ColtonTshudy/battery-node/simulations/FET Driver rev2 bjt_test.asc

C2: cap; 0.05µ
C3: cap; 0, ic=0
D4: zener; TDZ16B
D7: schottky; RB168L100
M1: nmos; R6020PNJ
Q1: npn; 2SCR542F3
Q2: npn; 2SCR542F3
Q3: pnp; 2SAR340P
R1: res; 100
R2: res; 10k
R3: res; 600
R4: res; 10Meg
R5: res; 10m
R6: res; 10k
R9: res; 75
R10: res; 1
V1: voltage; 60
V2: voltage; PULSE(0 -450 5m 1n 1 1 1 1)
V3: voltage; PULSE(-50 -60 5.1m 1n 1n 1 1 1)
V4: voltage; 12
Named nets: src, gate, 0
.tran 0 10m 0
.model Tvs d Ron=10m Vfwd=450 Vrev=450 Epsilon=1 RevEpsilon=1
.model DMZ6012E VDMOS(Rg=100 Vto=-2.2 Rd=25 Rs=5 Rb=40 Kp=0.1 mtriode=1 Cgdmax=20p Cgdmin=2p Cgs=60p Cjo=50p Vds=600 Ron=60 Qg=1.5n)
