ColtonTshudy/battery-node/simulations/FET Driver rev2 dep_fet_test.asc

C1: cap; 0.1µ
C2: cap; 0.05µ
C3: cap; 0, ic=0
D1: schottky; RB168MM100
D2: zener; TDZ16B
D3: schottky; RB168L100
D4: schottky; RB168MM100
D5: zener; UMZ5_1N
D6: TVSdiode; Tvs
D7: schottky; RB168L100
M1: nmos; R6020PNJ
M2: nmos; R6020PNJ
M3: nmos; AOB66916L
M4: pmos; IRF9640
M5: nmos; R6020PNJ
R1: res; 10Meg
R2: res; 10k
R3: res; 300
R4: res; 10Meg
R5: res; 10m
R6: res; 100
R7: res; 56k
R8: res; 806
R9: res; 25
R10: res; 1
R11: res; 300
R12: res; 10Meg
R13: res; 10k
V1: voltage; 60
V2: voltage; PULSE(0 -450 5m 1m 1 1 1 1)
V3: voltage; PULSE(12 -60 5.1m 1n 1n 1 1 1)
Named nets: div, src, gate, 0, drain
.tran 0 10m 0
.model Tvs d Ron=10m Vfwd=450 Vrev=450 Epsilon=1 RevEpsilon=1
.model DMZ6012E VDMOS(Rg=100 Vto=-2.2 Rd=25 Rs=5 Rb=40 Kp=0.1 mtriode=1 Cgdmax=20p Cgdmin=2p Cgs=60p Cjo=50p Vds=600 Ron=60 Qg=1.5n)
