ColtonTshudy/battery-node/simulations/FET Driver rev4_breaking_setup.asc

C1: cap; .1µ
C2: cap; 0.05µ
D1: schottky; RB168MM100
D2: zener; TDZ16B
D3: schottky; RB168L100
D4: zener; TDZ16B
D5: zener; UMZ5_1N
D6: TVSdiode; Tvs
M1: nmos; AOB66916L
M2: pmos; SQ4937EY_Q2
M3: nmos; AOB66916L
R1: res; 10Meg
R2: res; 10k
R3: res; 1k
R4: res; 10Meg
R5: res; 10m
R6: res; 10
R7: res; 100k
R8: res; 1
R9: res; 75
V1: voltage; 60
V2: voltage; PULSE(0 -50 5m 1m 1 1 1 1)
V3: voltage; PULSE(12 -60 5.01m 1n 1n 1 1 1)
Named nets: div, src, gate, term, 0, bat
.tran 0 10m 0
.model Tvs d Ron=10m Vfwd=100 Vrev=100 Epsilon=1 RevEpsilon=1
