ColtonTshudy/battery-node/simulations/NMOS Gate Charge Test.asc

A1: and; ref=3.6 rout=.1m vhigh=10 td=30
C1: cap; 1n ic=0
D1: diode
M1: nmos; AON6560
R1: res; .1
V1: voltage; 10
Named nets: cccv_in, cccv_out, 0
.model d d ron=.1m roff=1meg vfwd=0.0 ilimit=1
.tran 0 1u 0
