ColtonTshudy/battery-node/simulations/cell balance.asc

Q1: npn; PBSS4350T
R1: res; 100
R2: res; 10
R3: res; 25
R4: res; 220
R5: res; 100
V1: voltage; 4
Named nets: 0
.tran 0 1 0
.MODEL PBSS4350T NPN(IS=5E-15 NF=1.002 ISE=2E-14 NE=1.60 BF=220 IKF=1.8 VAF=80 NR=1.0 ISC=1E-14 NC=1.20 BR=8 IKR=0.5 VAR=12 RB=18 RBM=1.5 IRB=0.01 RE=0.04 RC=0.08 CJE=10E-12 VJE=0.75 MJE=0.33 CJC=2.5E-12 VJC=0.65 MJC=0.35 XCJC=0.75 TF=1.0E-9 XTF=3.0 VTF=5.0 ITF=0.8 TR=50E-9 XTB=1.60 EG=1.11 XTI=3.0 FC=0.5)
