ColtonTshudy/battery-node/simulations/Draft1.asc

Q1: npn; QSX2
R1: res; 330
R2: res; 10
R3: res; 25
R4: res; 82
R5: res; 330
V1: voltage; 4
Named nets: 0
.tran 0 1 0
