ColtonTshudy/battery-node/simulations/Draft2.asc

C1: cap; 1n, ic=0
C2: cap; 1n, ic=0
D1: diode
R2: res; 10k
R3: res; 1
V1: voltage; 60
Named nets: 0
.tran 0 1 0
.model d d ron=0 roff=1meg vfwd=0.4 ilimit=100u
