ColtonTshudy/battery-node/simulations/Draft3.asc

C1: cap; 1µ, ic=0
D1: schottky; BAT46WJ
M1: nmos; SPA11N60C3
R1: res; 10k
R2: res; 1
R3: res; 50
R4: res; 1Meg
V1: voltage; -450
V2: voltage; 10
V3: voltage; 60
Named nets: 0, v+, v-
.tran 0 1 0
I(R1)*(v(v+)-v(v-))
