ColtonTshudy/battery-node/simulations/Draft4.asc

M1: nmos; DMZ6012E
R1: res; 1k
V1: voltage; DC
V2: voltage; 70
Named nets: 0
.model DMZ6012E VDMOS(Rg=100 Vto=-2.2 Rd=25 Rs=5 Rb=40 Kp=0.1 mtriode=1 Cgdmax=20p Cgdmin=2p Cgs=60p Cjo=50p Vds=600 Ron=60 Qg=1.5n)
.dc V1 70 0 1
