ColtonTshudy/battery-node/simulations/FET Driver rev2 broken.asc

C1: cap; 0.1µ
C2: cap; 0.05µ
C3: cap; 60n, ic=0
D1: schottky; RB168MM100
D2: zener; TDZ16B
D3: schottky; RB168L100
D4: zener; TDZ16B
D5: zener; UMZ5_1N
D6: TVSdiode; Tvs
D9: diode; MMSD4148
M1: nmos; AOB66916L
M3: nmos; AOB66916L
M4: pmos; IRF9640
R1: res; 10Meg
R2: res; 10k
R3: res; 300
R4: res; 10Meg
R5: res; 10m
R6: res; 1.5k
R7: res; 56k
R8: res; 800
R9: res; 9.5
R10: res; 1
R11: res; 1k
V1: voltage; 60
V2: voltage; PULSE(0 -450 5m 1n 1 1 1 1)
V3: voltage; PULSE(12 -60 6m 1n 1n 1 1 1)
Named nets: div, src, gate, 0
.tran 0 10m 0
.model Tvs d Ron=10m Vfwd=450 Vrev=450 Epsilon=1 RevEpsilon=1
