ColtonTshudy/battery-node/simulations/LD Pin reverse polarity protection.asc

C1: cap; 1µ, ic=0
D2: diode; MMSD4148
D3: zener; KDZLV75
M1: nmos; DMZ6012E
R1: res; 10k
R2: res; 1
R3: res; 100
R4: res; 20k
V1: voltage; 120
V3: voltage; 70
Named nets: 0, v+, v-
.tran 0 1 0
I(R1)*(v(v+)-v(v-))
.model d d ron=0 roff=1meg vfwd=0 ilimit=100u
.model DMZ6012E VDMOS(Rg=100 Vto=-2.2 Rd=25 Rs=5 Rb=40 Kp=0.1 mtriode=1 Cgdmax=20p Cgdmin=2p Cgs=60p Cjo=50p Vds=600 Ron=60 Qg=1.5n)
