ColtonTshudy/battery-node/simulations/CC_CV_Source.asc

A1: and; ref=3.6 rout=.1m vhigh=15 td=30
C1: cap; 1 ic=0
D1: diode
Named nets: cccv_in, cccv_out, 0
.model d d ron=.1m roff=1meg vfwd=0.0 ilimit=100
.tran 0 1 0
