ColtonTshudy/battery-node/simulations/FET Driver rev2 working.asc

C1: cap; .1µ
C2: cap; 0.05µ
D1: schottky; RB168MM100
D2: zener; TDZ16B
D3: schottky; RB168L100
D4: zener; TDZ16B
D5: zener; UMZ5_1N
D6: TVSdiode; Tvs
L1: ind; 5µ
L2: ind; 10µ
M1: nmos; AOB66916L
M2: nmos; AOB66916L
M3: nmos; AOB66916L
M4: pmos; IRF9640
R1: res; 10Meg
R2: res; 10k
R3: res; 100
R4: res; 10Meg
R5: res; 10m
R6: res; 1
R7: res; 56k
R8: res; 1
R9: res; 1
S1: sw; Sa
V1: voltage; 60
V2: voltage; PULSE(0 -80 5m 1n 1n 1 1 1)
V3: voltage; PULSE(12 -60 5.01m 1n 1n 1 1 1)
V4: voltage; PULSE(0 1 5m 1n 1n 1 1 1)
V5: voltage; 12
Named nets: div, src, gate, term, 0
.tran 0 10m 0
.model Sa SW(Ron=1m Roff=10 Vt=0.5 Vh=0)
.model Tvs d Ron=10m Vfwd=100 Vrev=100 Epsilon=1 RevEpsilon=1
