ColtonTshudy/battery-node/bms-logic/battery-node.kicad_pcb

## KiCad design bms-logic/battery-node.kicad_pcb (2026-05-10)

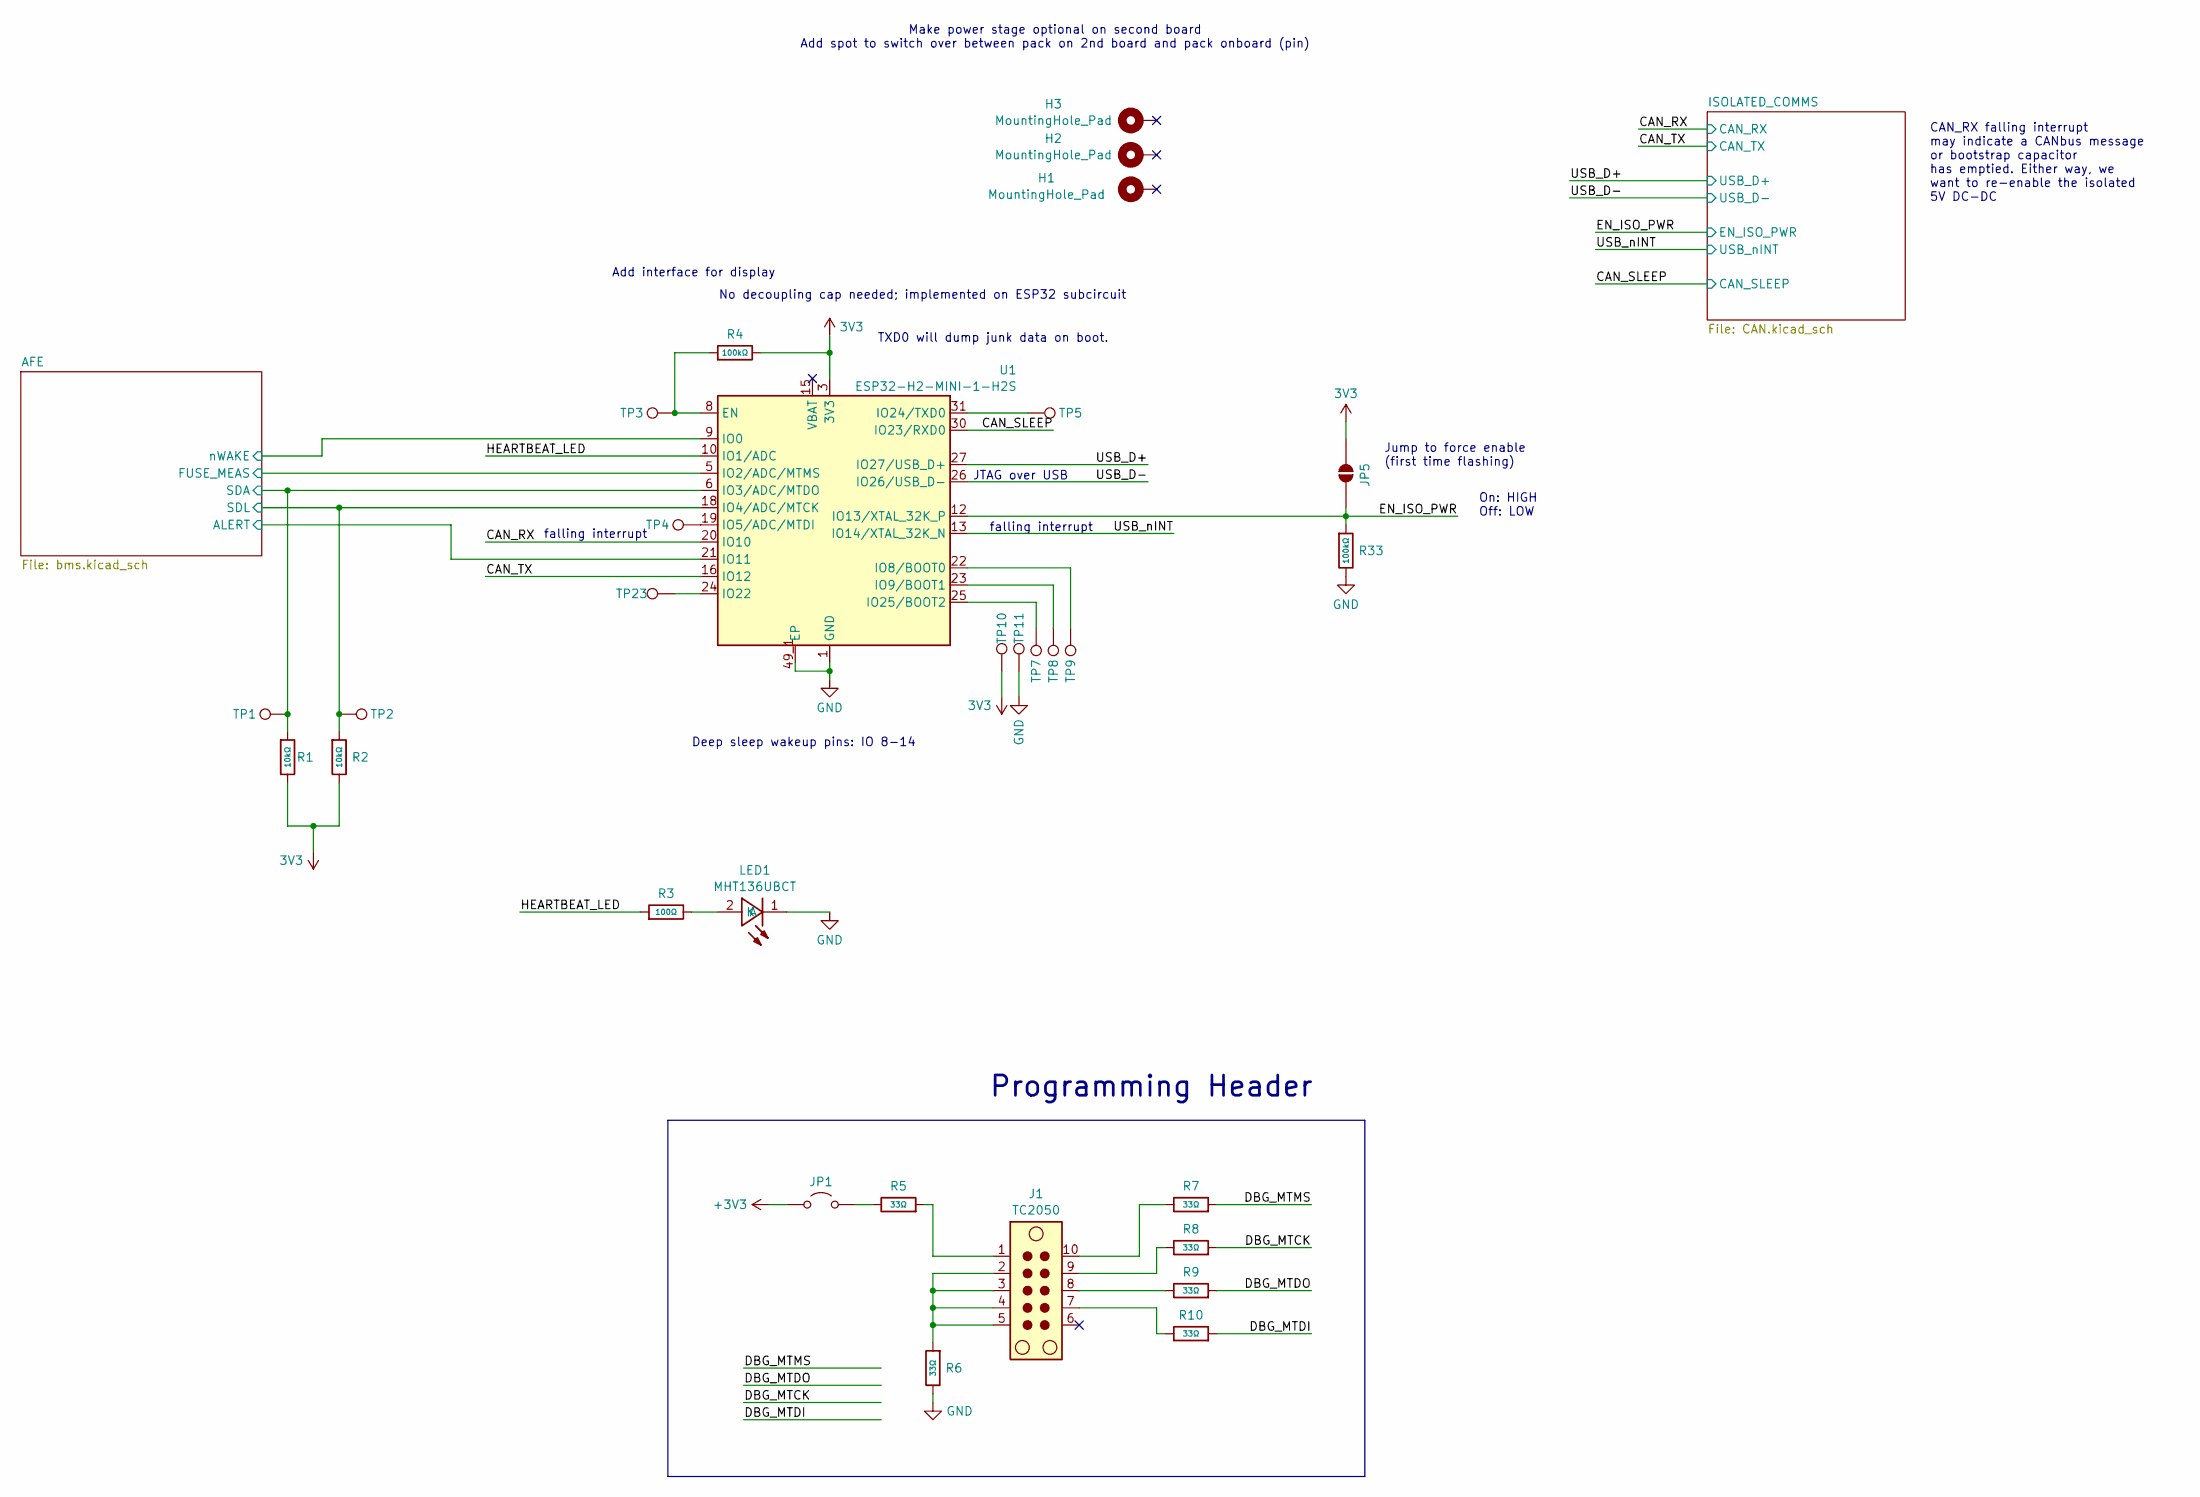
[picture p1: schematic battery-node.kicad_sch]

Parts:
H1, H2, H3: MountingHole_Pad; MountingHole_2.2mm_M2_DIN965_Pad_TopBottom
J1: TC2050; Tag-Connect_TC2050-IDC-NL_2x05_P1.27mm_Vertical
JP1: Jumper_2_Open; SolderJumper-2_P1.3mm_Open_RoundedPad1.0x1.5mm
JP5: SolderJumper_2_Open; SolderJumper-2_P1.3mm_Open_RoundedPad1.0x1.5mm
LED1: MHT136UBCT; Manufacturer Part MHT136UBCT; LCSC C401112
R1, R2: 10kΩ; R_0402; Overload Voltage (Max) 50V; Tolerance ±1%; Part 0402WGF1002TCE; LCSC C25744
R3: 100Ω; R_0402; Overload Voltage (Max) 50V; Tolerance ±1%; Part 0402WGF1000TCE; LCSC C25076
R4, R33: 100kΩ; R_0402; Overload Voltage (Max) 50V; Tolerance ±1%; Part 0402WGF1003TCE; LCSC C25741
R5, R6, R7, R8, R9, R10: 33Ω; R_0402; Overload Voltage (Max) 50V; Tolerance ±1%; Part 0402WGF330JTCE; LCSC C25105
TP1, TP2, TP3, TP4, TP5, TP10, TP11, TP23: IO25; TestPoint_Pad_D1.0mm
TP7, TP8, TP9: IO9; TestPoint_Pad_D1.0mm
U1: ESP32-H2-MINI-1-H2S; MODULE_ESP32-H2-MINI-1-H2; Part ESP32-H2-MINI-1-H2S

Connections:
3V3: JP5.2 (B), R1.2, R2.2, R4.2, TP10.1 (1_1), U1.3 (3V3); also elsewhere on the board
/AFE/ALERT: U1.21 (IO11); also elsewhere on the board
/AFE/FUSE_MEAS: U1.5 (IO2/ADC/MTMS)
/AFE/SDA: R1.1, TP1.1 (1_1), U1.6 (IO3/ADC/MTDO); also elsewhere on the board
/AFE/SDL: R2.1, TP2.1 (1_1), U1.18 (IO4/ADC/MTCK); also elsewhere on the board
/AFE/nWAKE: U1.9 (IO0); also elsewhere on the board
/CAN_RX: U1.20 (IO10); also elsewhere on the board
/CAN_SLEEP: U1.30 (IO23/RXD0); also elsewhere on the board
/CAN_TX: U1.16 (IO12); also elsewhere on the board
/EN_ISO_PWR: JP5.1 (A), R33.1, U1.12 (IO13/XTAL_32K_P); also elsewhere on the board
/HEARTBEAT_LED: R3.1, U1.10 (IO1/ADC)
/USB_D+: U1.27 (IO27/USB_D+); also elsewhere on the board
/USB_D-: U1.26 (IO26/USB_D-); also elsewhere on the board
/USB_nINT: U1.13 (IO14/XTAL_32K_N); also elsewhere on the board
GND: LED1.1 (K), R6.2, R33.2, TP11.1 (1_1), U1.1 (GND), U1.2 (GND), U1.11 (GND), U1.14 (GND), U1.36 (GND), U1.37 (GND), U1.38 (GND), U1.39 (GND), U1.40 (GND), U1.41 (GND), U1.42 (GND), U1.43 (GND), U1.44 (GND), U1.45 (GND), U1.46 (GND), U1.47 (GND), U1.48 (GND), U1.49_1 (EP), U1.49_2 (EP), U1.49_3 (EP), U1.49_4 (EP), U1.49_5 (EP), U1.49_6 (EP), U1.49_7 (EP), U1.49_8 (EP), U1.49_9 (EP), U1.50 (GND), U1.51 (GND), U1.52 (GND), U1.53 (GND), U1.54 (EP), U1.55 (EP), U1.56 (EP), U1.57 (EP), U1.58 (EP), U1.59 (EP), U1.60 (EP), U1.61 (EP), U1.62 (EP), U1.63 (EP), U1.64 (EP), U1.65 (EP); also elsewhere on the board
unnamed: J1.1, R5.1
unnamed: J1.2, J1.3, J1.4, J1.5, R6.1
unnamed: J1.7, R10.2
unnamed: J1.8, R9.2
unnamed: J1.9, R8.2
unnamed: J1.10, R7.2
unnamed: JP1.2 (B), R5.2
unnamed: LED1.2 (A), R3.2
unnamed: R4.1, TP3.1 (1_1), U1.8 (EN)
unnamed: TP4.1 (1_1), U1.19 (IO5/ADC/MTDI)
unnamed: TP9.1 (1_1), U1.22 (IO8/BOOT0)
unnamed: TP8.1 (1_1), U1.23 (IO9/BOOT1)
unnamed: TP23.1 (1_1), U1.24 (IO22)
unnamed: TP5.1 (1_1), U1.31 (IO24/TXD0)
unnamed: TP7.1 (1_1), U1.25 (IO25/BOOT2)

Notes on the sheet:
Jump to force enable (first time flashing)
On: HIGH Off: LOW
No decoupling cap needed; implemented on ESP32 subcircuit
CAN_RX falling interrupt may indicate a CANbus message or bootstrap capacitor has emptied. Either way, we want to re-enable the isolated 5V DC-DC
Make power stage optional on second board Add spot to switch over between pack on 2nd board and pack onboard (pin)
Deep sleep wakeup pins: IO 8-14
JTAG over USB
Add interface for display
Programming Header
falling interrupt
TXD0 will dump junk data on boot.

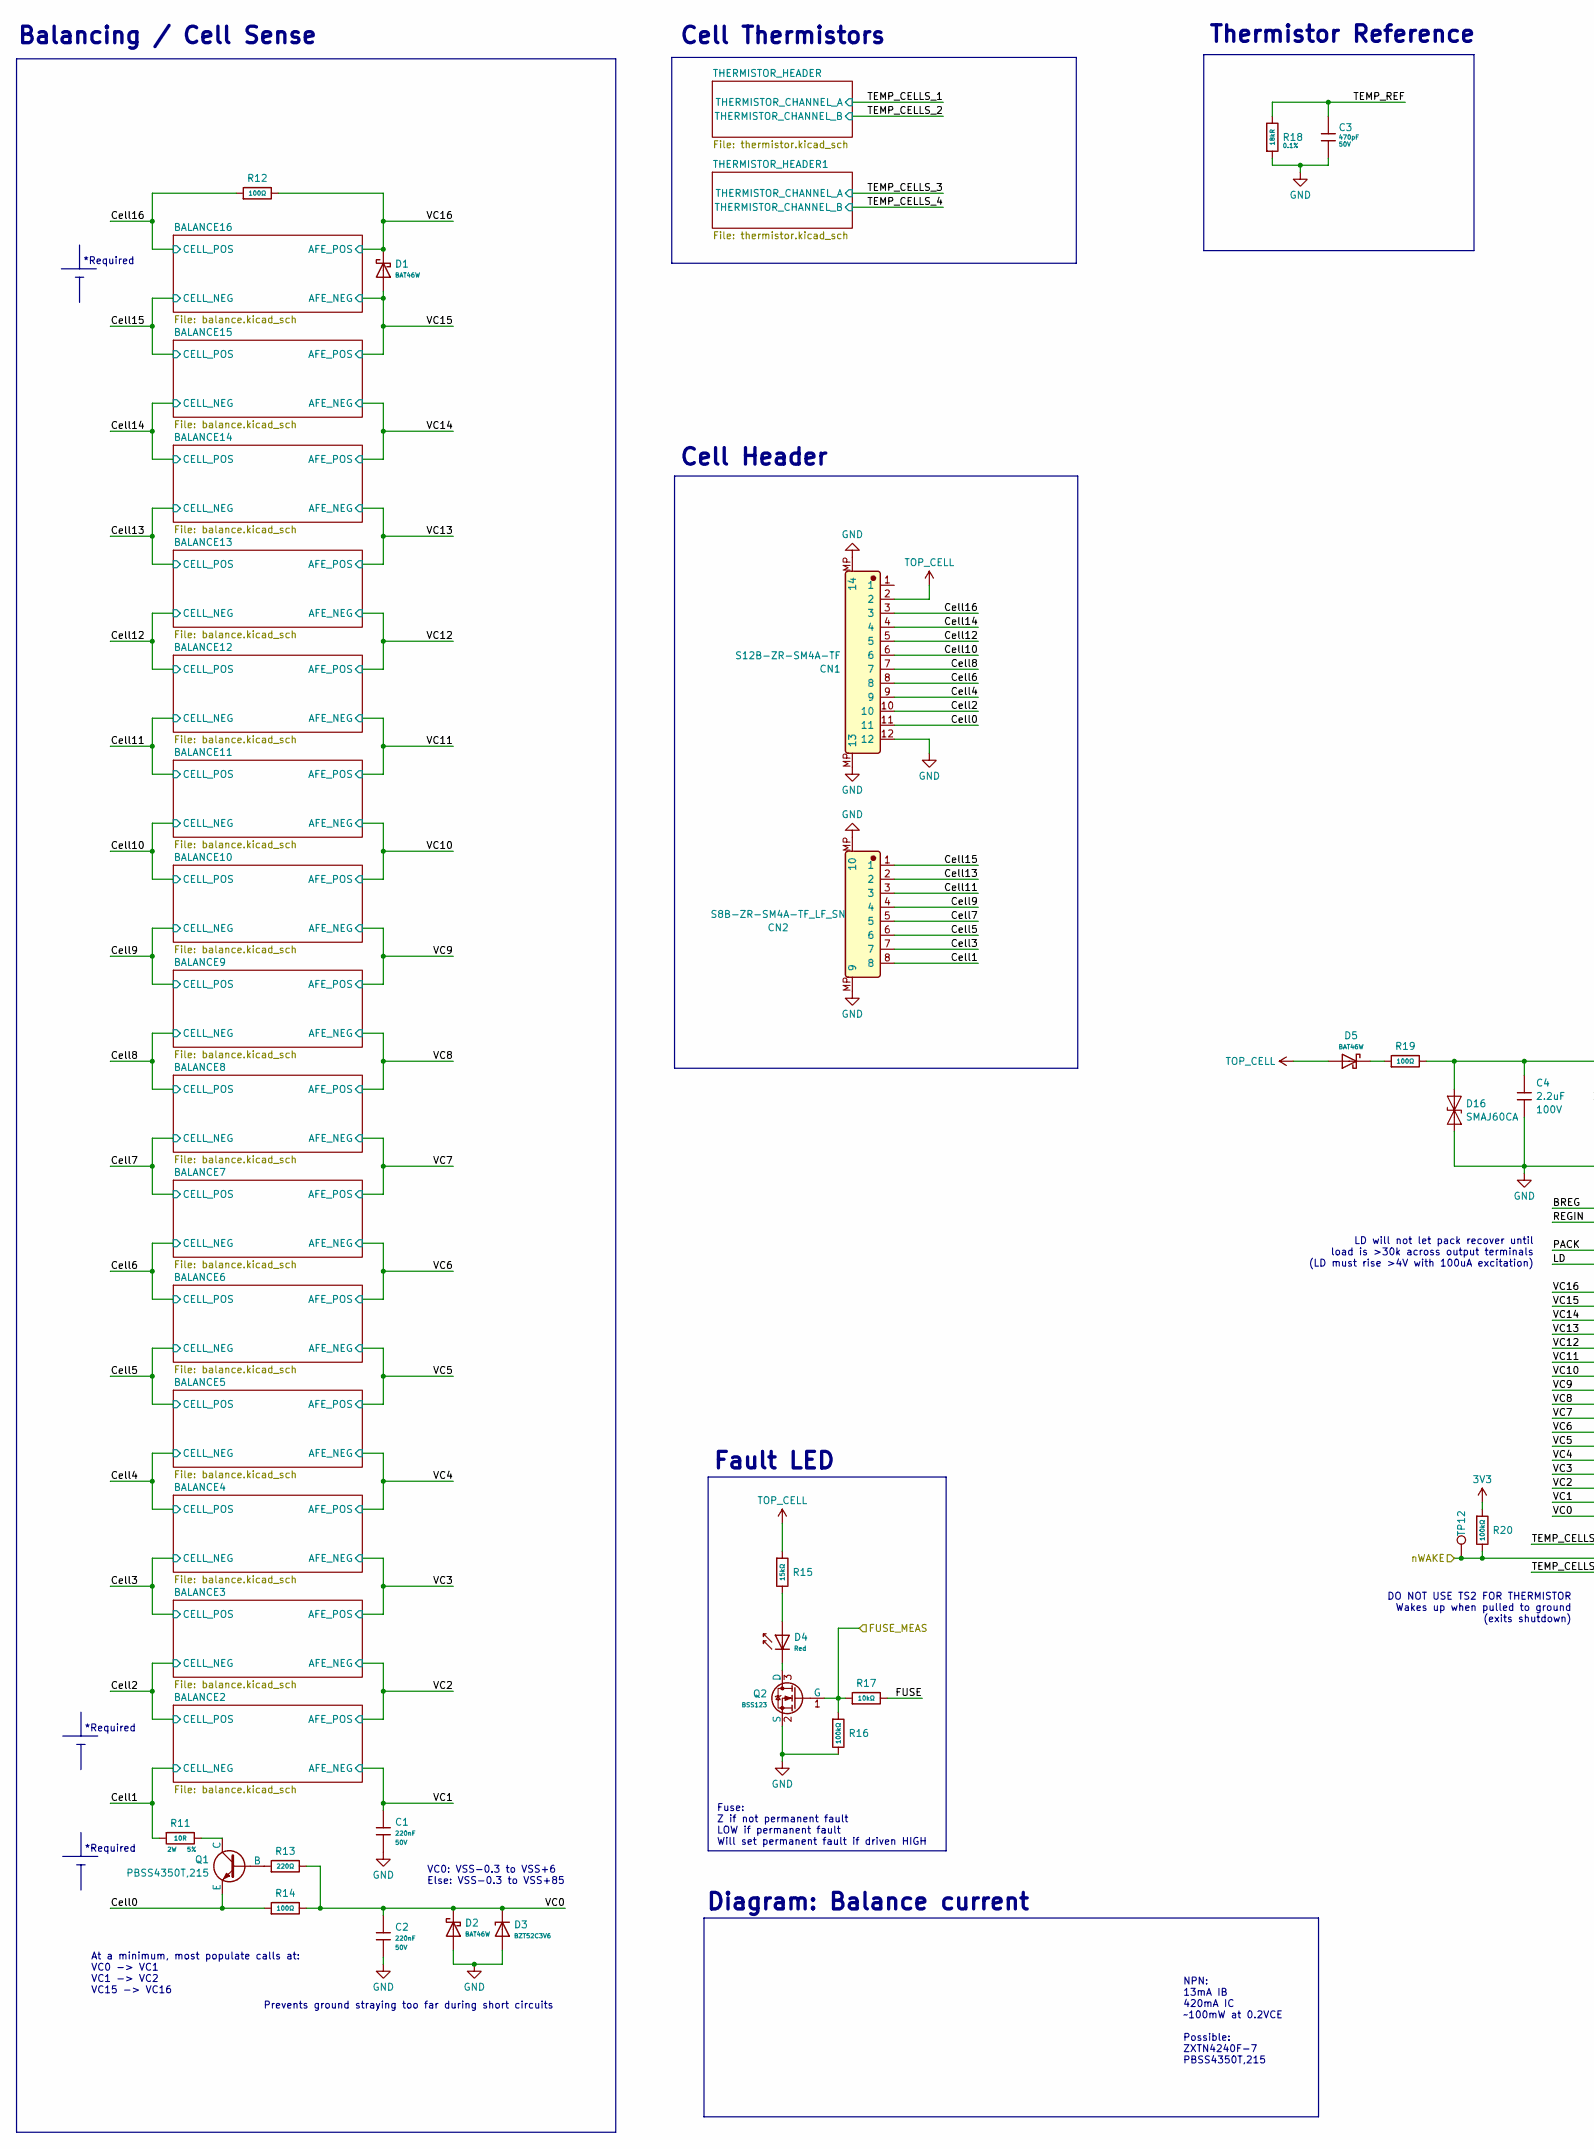
[picture p2: schematic bms.kicad_sch, part in row 1, column 1]

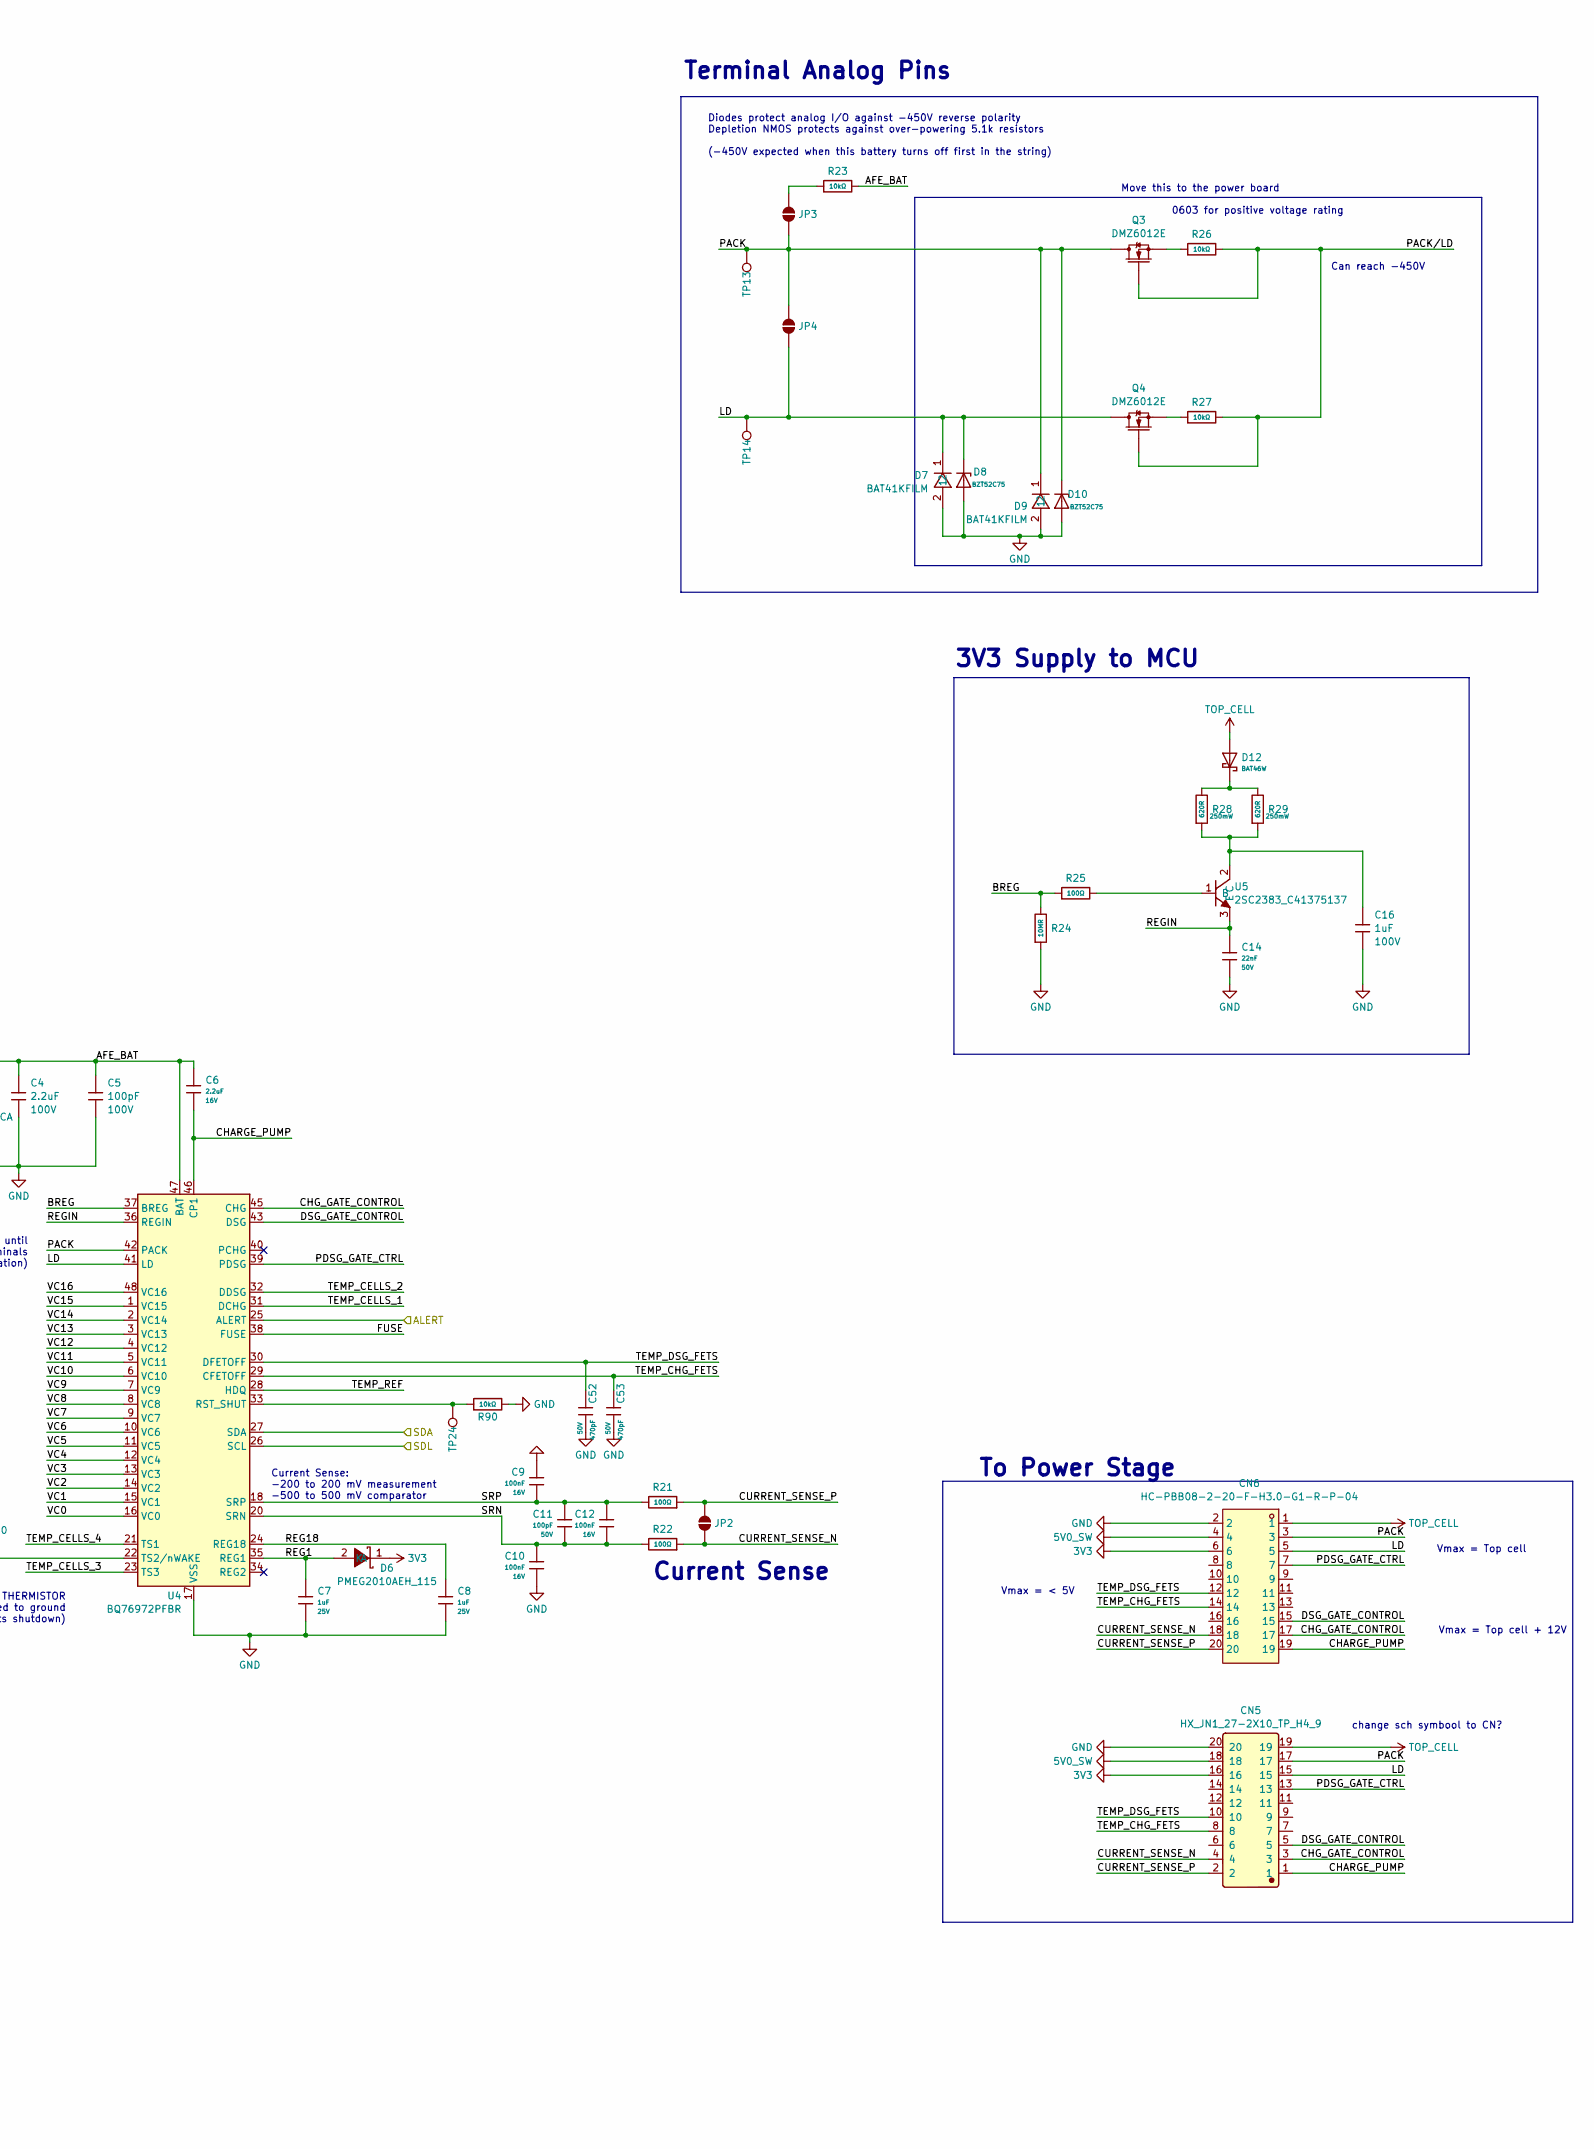
[picture p3: schematic bms.kicad_sch, part in row 1, column 2]

Parts:
C1, C2: 220nF; C_0805; Voltage Rated 50V; Tolerance ±10%; Part CL21B224KBFNNNE; LCSC C5378
C3, C52, C53: 470pF; C_0402; Voltage Rated 50V; Tolerance ±10%; Part 0402B471K500NT; LCSC C1537
C4: 2.2uF; C_1206; Tolerance 10%; Voltage 100V; Part CC1206KKX7R0BB225
C5: 100pF; C_0603; Tolerance 5%; Voltage 100V; Part CC0603JRNPO0BN101
C6: 2.2uF; C_0603; Voltage Rated 16V; Tolerance ±10%; Part CL10A225KO8NNNC; LCSC C23630
C7, C8: 1uF; C_0402; Voltage Rated 25V; Tolerance ±10%; Part CL05A105KA5NQNC; LCSC C52923
C9, C10, C12: 100nF; C_0402; Voltage Rated 16V; Tolerance ±10%; Part CL05B104KO5NNNC; LCSC C1525
C11: 100pF; C_0402; Voltage Rated 50V; Tolerance ±5%; Part 0402CG101J500NT; LCSC C1546
C14: 22nF; C_0402; Voltage Rated 50V; Tolerance ±10%; Part 0402B223K500NT; LCSC C1532
C16: 1uF; C_0805; Tolerance 10%; Voltage 100V; Part CC0805KKX7R0BB105
CN1: S12B-ZR-SM4A-TF; JST_ZH_S12B-ZR-SM4A-TF_1x12-1MP_P1.50mm_Horizontal; Manufacturer Part S12B-ZR-SM4A-TF; LCSC C20089235
CN2: S8B-ZR-SM4A-TF_LF_SN; JST_ZH_S8B-ZR-SM4A-TF_1x08-1MP_P1.50mm_Horizontal; Manufacturer Part S8B-ZR-SM4A-TF(LF)(SN); LCSC C471474
CN5: HX_JN1_27-2X10_TP_H4_9; Manufacturer Part HX JN1.27-2x10 TP H4.9; LCSC C42455947
CN6: HC-PBB08-2-20-F-H3.0-G1-R-P-04; CONN-SMD_20P-P0.80_HC-PBB08-2-20-F-H4.0-G1-R-P-04; MPN HC-PBB08-2-20-F-H3.0-G1-R-P-04; LCSC Part C41421148
D1, D2, D5, D12: BAT46W; D_SOD-123; Forward Voltage (Vf@If) 450mV@10mA; Reverse Voltage (Vr) 100V; Part BAT46W; LCSC C7420332
D3: BZT52C3V6; D_SOD-123; Part BZT52C3V6; LCSC C19077397
D4: Red; D_0603; Part KT-0603R; LCSC C2286
D6: PMEG2010AEH_115; D_SOD-123FL; Manufacturer Part PMEG2010AEH,115; LCSC C110921
D7, D9: BAT41KFILM; D_SOD-523; Manufacturer Part BAT41KFILM; LCSC C73150
D8, D10: BZT52C75; D_SOD-123; Part BZT52C75; LCSC C22375297
D16: SMAJ60CA; D_SMA
JP2, JP3, JP4: SolderJumper_2_Open; SolderJumper-2_P1.3mm_Open_RoundedPad1.0x1.5mm
Q1: PBSS4350T,215; SOT-23; Part PBSS4350T,215
Q2: BSS123; Q_SOT-23; Part BSS123; LCSC C7420338
Q3, Q4: DMZ6012E; TSOT-23; Part DMZ6012E
R11: 10R; R_2512_6332Metric; Tolerance 5%; Part FRP2512J100 TS
R12, R14, R21, R22, R25: 100Ω; R_0402; Overload Voltage (Max) 50V; Tolerance ±1%; Part 0402WGF1000TCE; LCSC C25076
R13: 220Ω; R_0402; Tolerance ±1%; Overload Voltage (Max) 50V; Part 0402WGF2200TCE; LCSC C25091
R15: 15kΩ; R_0603; Overload Voltage (Max) 75V; Tolerance ±1%; Part 0603WAF1502T5E; LCSC C22809
R16, R20: 100kΩ; R_0402; Overload Voltage (Max) 50V; Tolerance ±1%; Part 0402WGF1003TCE; LCSC C25741
R17, R90: 10kΩ; R_0402; Overload Voltage (Max) 50V; Tolerance ±1%; Part 0402WGF1002TCE; LCSC C25744
R18: 18kR; R_0402; Tolerance 0.1%; Part RT0402BRD0718KL
R19: 100Ω; R_0603; Overload Voltage (Max) 75V; Tolerance ±1%; Part 0603WAF1000T5E; LCSC C22775
R23, R26, R27: 10kΩ; R_0603; Overload Voltage (Max) 75V; Tolerance ±1%; Part 0603WAF1002T5E; LCSC C25804
R24: 10MR; R_0402; Tolerance 5%; Part RC0402JR-0710ML
R28, R29: 620R; R_1206; Tolerance 1%; Part 1206W4F6200T5E
TP12, TP13, TP14, TP24: IO8; TestPoint_Pad_D1.0mm
U4: BQ76972PFBR; BQ76972
U5: 2SC2383_C41375137; SOT-89-3; Manufacturer Part 2SC2383; LCSC C41375137

Connections:
3V3: CN5.16, CN6.6, D6.1 (K), R20.1; also elsewhere on the board
5V0_SW: CN5.18, CN6.4; also elsewhere on the board
/AFE/AFE_BAT: C4.1, C5.1, C6.1, D16.2 (A2), R19.2, R23.2, U4.47 (BAT)
/AFE/ALERT: U4.25 (ALERT); also elsewhere on the board
/AFE/BREG: R24.1, R25.1, U4.37 (BREG)
/AFE/CHARGE_PUMP: C6.2, CN5.1, CN6.19, U4.46 (CP1)
/AFE/CHG_GATE_CONTROL: CN5.3, CN6.17, U4.45 (CHG)
/AFE/CURRENT_SENSE_N: CN5.4, CN6.18, JP2.1 (A), R22.1
/AFE/CURRENT_SENSE_P: CN5.2, CN6.20, JP2.2 (B), R21.1
/AFE/Cell0: CN1.11, Q1.2 (E), R14.1
/AFE/Cell1: CN2.8, R11.2; also elsewhere on the board
/AFE/Cell2: CN1.10; also elsewhere on the board
/AFE/Cell3: CN2.7; also elsewhere on the board
/AFE/Cell4: CN1.9; also elsewhere on the board
/AFE/Cell5: CN2.6; also elsewhere on the board
/AFE/Cell6: CN1.8; also elsewhere on the board
/AFE/Cell7: CN2.5; also elsewhere on the board
/AFE/Cell8: CN1.7; also elsewhere on the board
/AFE/Cell9: CN2.4; also elsewhere on the board
/AFE/Cell10: CN1.6; also elsewhere on the board
/AFE/Cell11: CN2.3; also elsewhere on the board
/AFE/Cell12: CN1.5; also elsewhere on the board
/AFE/Cell13: CN2.2; also elsewhere on the board
/AFE/Cell14: CN1.4; also elsewhere on the board
/AFE/Cell15: CN2.1; also elsewhere on the board
/AFE/Cell16: CN1.3, R12.1; also elsewhere on the board
/AFE/DSG_GATE_CONTROL: CN5.5, CN6.15, U4.43 (DSG)
/AFE/FUSE: R17.2, U4.38 (FUSE)
/AFE/LD: CN5.15, CN6.5, D7.1, D8.1, JP4.1 (A), Q4.3 (D), TP14.1 (1_1), U4.41 (LD)
/AFE/PACK: CN5.17, CN6.3, D9.1, D10.1, JP3.1 (A), JP4.2 (B), Q3.3 (D), TP13.1 (1_1), U4.42 (PACK)
/AFE/PDSG_GATE_CTRL: CN5.13, CN6.7, U4.39 (PDSG)
/AFE/REG1: C7.1, D6.2 (A), U4.35 (REG1)
/AFE/REG18: C8.1, U4.24 (REG18)
/AFE/REGIN: C14.1, U4.36 (REGIN), U5.3 (E)
/AFE/SDA: U4.27 (SDA); also elsewhere on the board
/AFE/SDL: U4.26 (SCL); also elsewhere on the board
/AFE/SRN: C10.1, C11.2, C12.2, R22.2, U4.20 (SRN)
/AFE/SRP: C9.2, C11.1, C12.1, R21.2, U4.18 (SRP)
/AFE/TEMP_CELLS_1: U4.31 (DCHG); also elsewhere on the board
/AFE/TEMP_CELLS_2: U4.32 (DDSG); also elsewhere on the board
/AFE/TEMP_CELLS_3: U4.23 (TS3); also elsewhere on the board
/AFE/TEMP_CELLS_4: U4.21 (TS1); also elsewhere on the board
/AFE/TEMP_CHG_FETS: C53.1, CN5.8, CN6.14, U4.29 (CFETOFF)
/AFE/TEMP_DSG_FETS: C52.1, CN5.10, CN6.12, U4.30 (DFETOFF)
/AFE/TEMP_REF: C3.1, R18.1, U4.28 (HDQ)
/AFE/VC0: C2.1, D2.1, D3.1, R13.2, R14.2, U4.16 (VC0)
/AFE/VC1: C1.1, U4.15 (VC1); also elsewhere on the board
/AFE/VC2: U4.14 (VC2); also elsewhere on the board
/AFE/VC3: U4.13 (VC3); also elsewhere on the board
/AFE/VC4: U4.12 (VC4); also elsewhere on the board
/AFE/VC5: U4.11 (VC5); also elsewhere on the board
/AFE/VC6: U4.10 (VC6); also elsewhere on the board
/AFE/VC7: U4.9 (VC7); also elsewhere on the board
/AFE/VC8: U4.8 (VC8); also elsewhere on the board
/AFE/VC9: U4.7 (VC9); also elsewhere on the board
/AFE/VC10: U4.6 (VC10); also elsewhere on the board
/AFE/VC11: U4.5 (VC11); also elsewhere on the board
/AFE/VC12: U4.4 (VC12); also elsewhere on the board
/AFE/VC13: U4.3 (VC13); also elsewhere on the board
/AFE/VC14: U4.2 (VC14); also elsewhere on the board
/AFE/VC15: D1.2, U4.1 (VC15); also elsewhere on the board
/AFE/VC16: D1.1, R12.2, U4.48 (VC16); also elsewhere on the board
/AFE/nWAKE: R20.2, TP12.1 (1_1), U4.22 (TS2/nWAKE); also elsewhere on the board
GND: C1.2, C2.2, C3.2, C4.2, C5.2, C7.2, C8.2, C9.1, C10.2, C14.2, C16.2, C52.2, C53.2, CN1.12, CN1.MP (14), CN2.MP (10), CN5.20, CN6.2, D2.2, D3.2, D7.2, D8.2, D9.2, D10.2, D16.1 (A1), Q2.2 (S), R16.2, R18.2, R24.2, R90.2, U4.17 (VSS); also elsewhere on the board
unnamed: D4.1, Q2.3 (D)
unnamed: D4.2, R15.2
unnamed: D5.1, R19.1
unnamed: D12.1, R28.1, R29.1
unnamed: JP3.2 (B), R23.1
unnamed: Q1.1 (B), R13.1
unnamed: Q1.3 (C), R11.1
unnamed: Q2.1 (G), R16.1, R17.1
unnamed: Q3.1 (G), Q4.1 (G), R26.2, R27.2
unnamed: Q3.2 (S), R26.1
unnamed: Q4.2 (S), R27.1
unnamed: R90.1, TP24.1 (1_1), U4.33 (RST_SHUT)
unnamed: R25.2, U5.1 (B)
unnamed: C16.1, R28.2, R29.2, U5.2 (C)
TOP_CELL: CN1.2, CN5.19, CN6.1, D5.2, D12.2, R15.1; also elsewhere on the board

Notes on the sheet:
change sch symbool to CN?
Vmax = < 5V
At a minimum, most populate calls at: VC0 -> VC1 VC1 -> VC2 VC15 -> VC16
Can reach -450V
Cell Thermistors
*Required
Thermistor Reference
Cell Header
Diagram: Balance current
Move this to the power board
To Power Stage
LD will not let pack recover until load is >30k across output terminals (LD must rise >4V with 100uA excitation)
VC0: VSS-0.3 to VSS+6 Else: VSS-0.3 to VSS+85
Fuse: Z if not permanent fault LOW if permanent fault Will set permanent fault if driven HIGH
Vmax = Top cell + 12V
DO NOT USE TS2 FOR THERMISTOR Wakes up when pulled to ground (exits shutdown)
Prevents ground straying too far during short circuits
Fault LED
Vmax = Top cell
0603 for positive voltage rating
Current Sense
Diodes protect analog I/O against -450V reverse polarity Depletion NMOS protects against over-powering 5.1k resistors (-450V expected when this battery turns off first in the string)
NPN: 13mA IB 420mA IC ~100mW at 0.2VCE Possible: ZXTN4240F-7 PBSS4350T,215
Current Sense: -200 to 200 mV measurement -500 to 500 mV comparator
3V3 Supply to MCU
Terminal Analog Pins
Balancing / Cell Sense

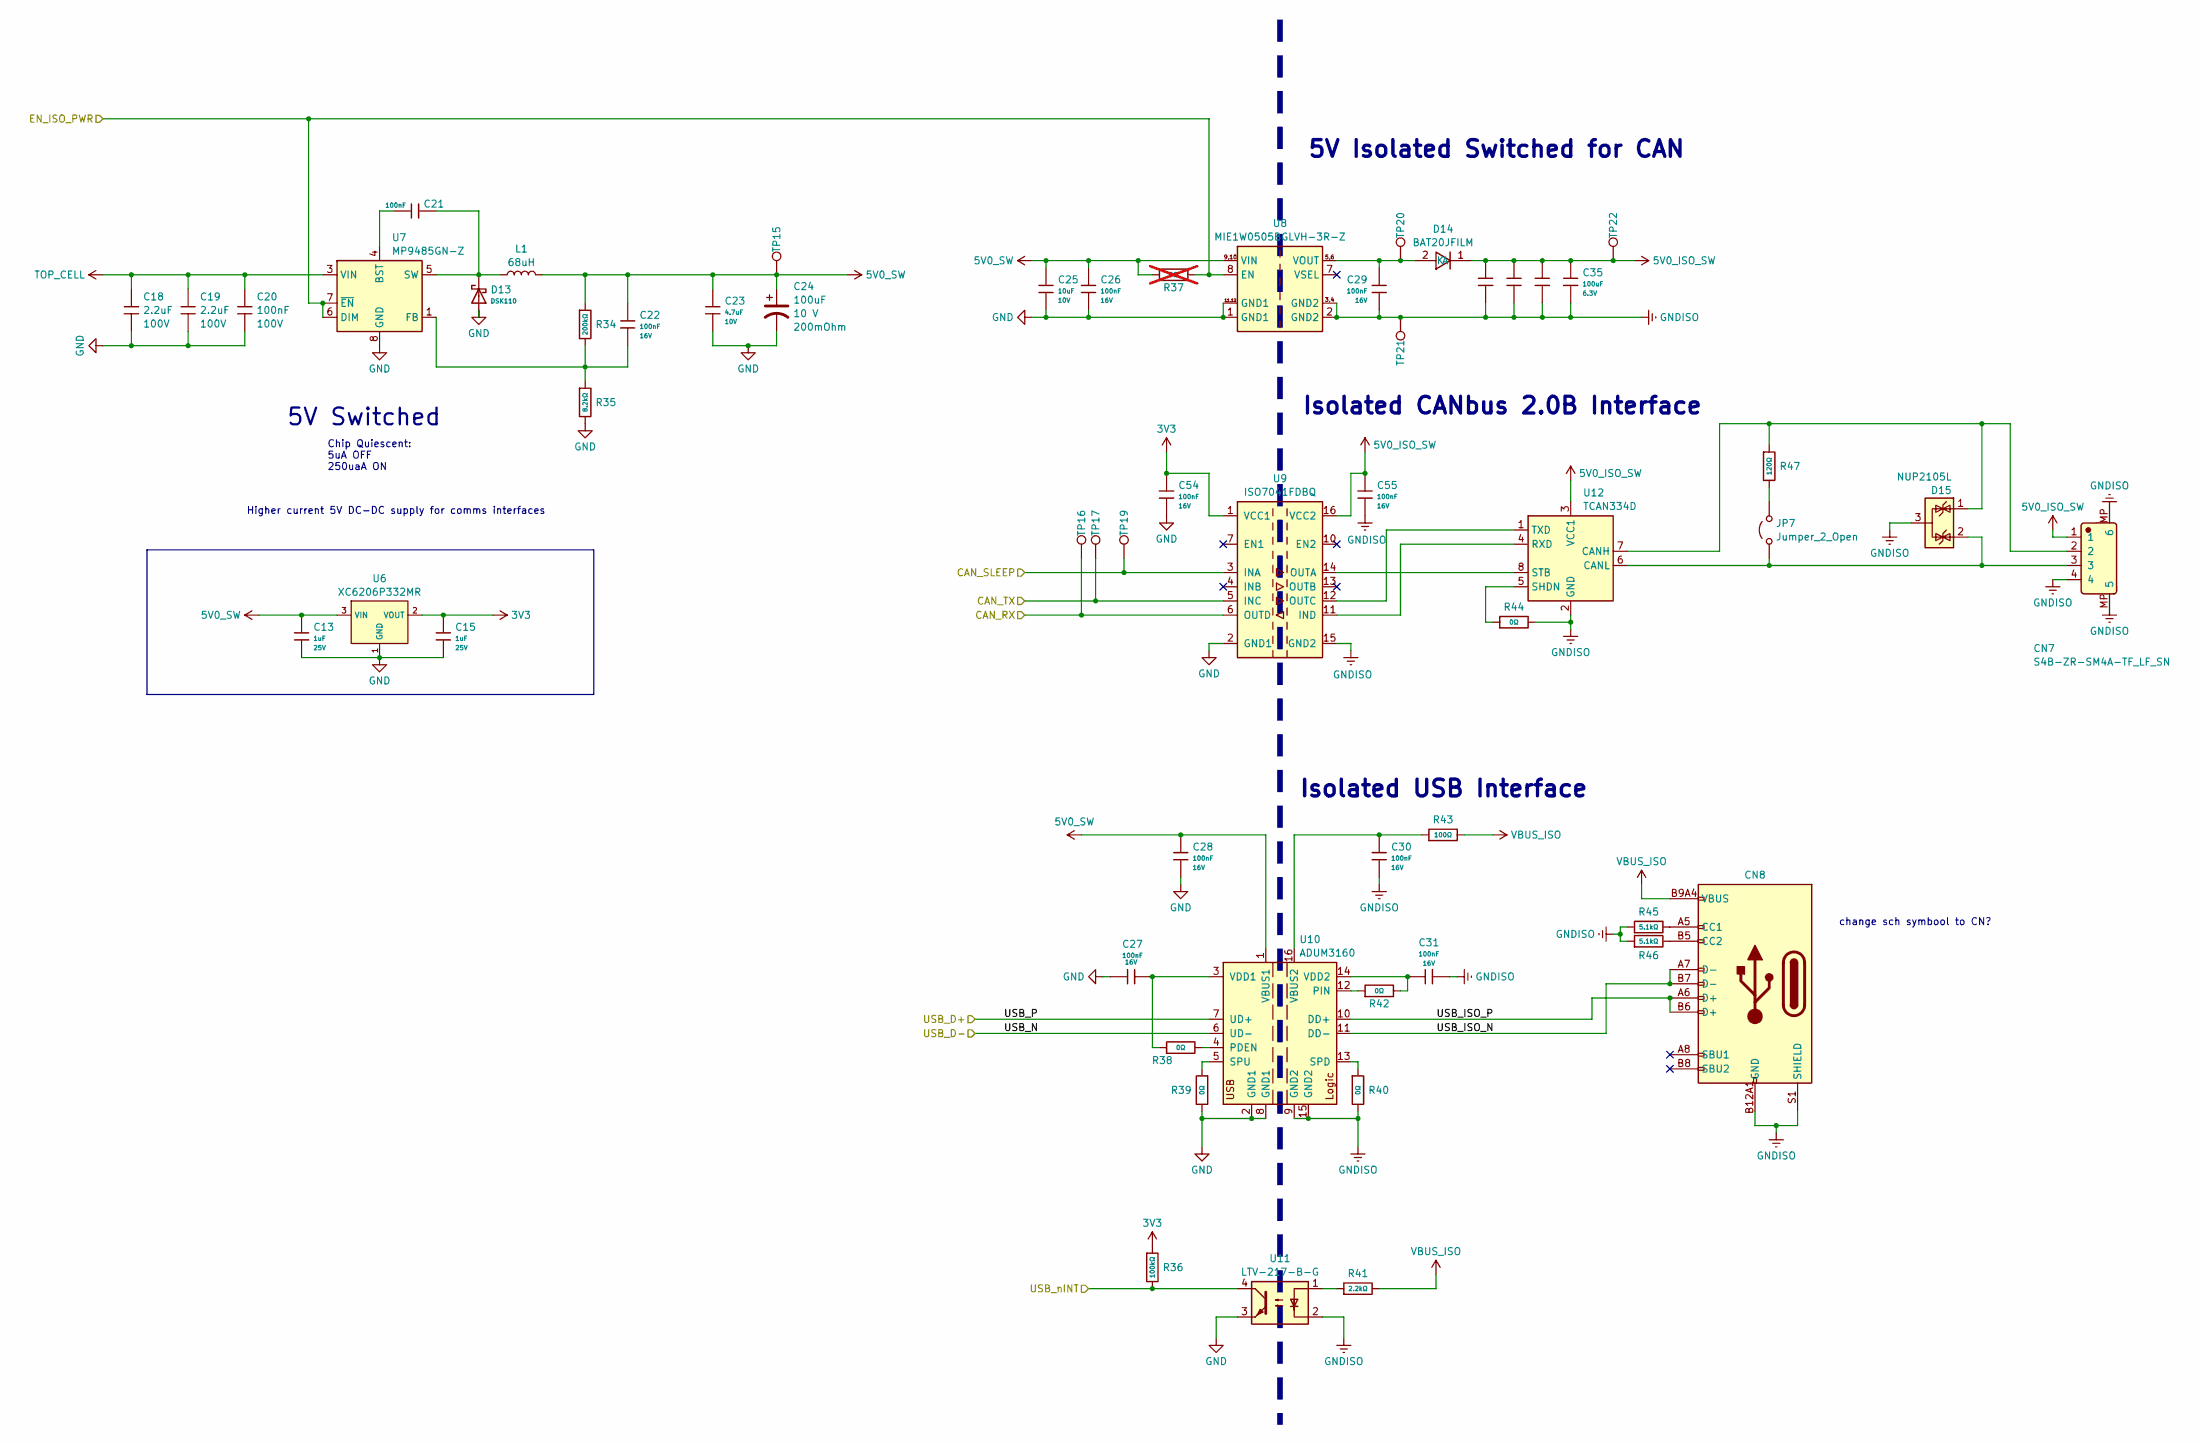
[picture p4: schematic CAN.kicad_sch]

Parts:
C13, C15: 1uF; C_0402; Voltage Rated 25V; Tolerance ±10%; Part CL05A105KA5NQNC; LCSC C52923
C18, C19: 2.2uF; C_1206; Tolerance 10%; Voltage 100V; Part CC1206KKX7R0BB225
C20: 100nF; C_0805; Tolerance 10%; Voltage 100V; Part CL21B104KCFNNNE
C21, C22, C26, C27, C28, C29, C30, C31, C54, C55: 100nF; C_0402; Voltage Rated 16V; Tolerance ±10%; Part CL05B104KO5NNNC; LCSC C1525
C23: 4.7uF; C_0402; Voltage Rated 10V; Tolerance ±20%; Part CL05A475MP5NRNC; LCSC C23733
C24: 100uF; CP_EIA-6032-20_AVX-F; Tolerance 10%; Voltage 10 V; Part TR3C107K010C0200
C25: 10uF; C_0603; Voltage Rated 10V; Tolerance ±10%; Part CL10A106KP8NNNC; LCSC C19702
C32, C33, C34, C35: 100uF; C_1206; Voltage Rated 6.3V; Tolerance ±20%; Part CL31A107MQHNNNE; LCSC C15008
CN7: S4B-ZR-SM4A-TF_LF_SN; JST_ZH_S4B-ZR-SM4A-TF_1x04-1MP_P1.50mm_Horizontal; Manufacturer Part S4B-ZR-SM4A-TF(LF)(SN); LCSC C485354
CN8: Connector, USB-TYPE-C-16P; TYPE-C-SMD_HX-TYPE-C-16PIN; LCSC C2927039
D13: DSK110; D_SOD-123FL; Part DSK110; LCSC C22466354
D14: BAT20JFILM; Manufacturer Part BAT20JFILM; LCSC C155590
D15: NUP2105L; SOT-23
JP7: Jumper_2_Open; SolderJumper-2_P1.3mm_Open_RoundedPad1.0x1.5mm
L1: 68uH; L_Changjiang_FTC404020S; Tolerance 20%; Part FNR4020S680MT
R34: 200kΩ; R_0402; Overload Voltage (Max) 50V; Tolerance ±1%; Part 0402WGF2003TCE; LCSC C25764
R35: 8.2kΩ; R_0402; Overload Voltage (Max) 50V; Tolerance ±1%; Part 0402WGF8201TCE; LCSC C25924
R36: 100kΩ; R_0402; Overload Voltage (Max) 50V; Tolerance ±1%; Part 0402WGF1003TCE; LCSC C25741
R37: 0Ω; R_0402; Overload Voltage (Max) 50V; Tolerance ±1%; Part 0402WGF0000TCE; LCSC C17168; not fitted
R38, R39, R40, R42, R44: 0Ω; R_0402; Overload Voltage (Max) 50V; Tolerance ±1%; Part 0402WGF0000TCE; LCSC C17168
R41: 2.2kΩ; R_0402; Overload Voltage (Max) 50V; Tolerance ±1%; Part 0402WGF2201TCE; LCSC C25879
R43: 100Ω; R_0402; Overload Voltage (Max) 50V; Tolerance ±1%; Part 0402WGF1000TCE; LCSC C25076
R45, R46: 5.1kΩ; R_0402; Overload Voltage (Max) 50V; Tolerance ±1%; Part 0402WGF5101TCE; LCSC C25905
R47: 120Ω; R_0402; Overload Voltage (Max) 50V; Tolerance ±1%; Part 0402WGF1200TCE; LCSC C25079
TP15, TP16, TP17, TP19, TP20, TP21, TP22: IO8; TestPoint_Pad_D1.0mm
U6: XC6206P332MR; SOT-23-3_L2.9-W1.6-P1.90-LS2.8-BR; Output Voltage 3.3V; Dropout Voltage 680mV@(100mA); Part XC6206P332MR-G; LCSC C5446
U7: MP9485GN-Z
U8: MIE1W0505BGLVH-3R-Z
U9: ISO7041FDBQ; SOIC-16W_7.5x10.3mm_P1.27mm
U10: ADUM3160; SOIC-16W_7.5x10.3mm_P1.27mm
U11: LTV-217-B-G; SOP-4_4.4x2.6mm_P1.27mm; Part LTV-217-B-G; LCSC C115450
U12: TCAN334D

Connections:
3V3: C15.1, C54.1, R36.1, U6.2 (VOUT), U9.1 (VCC1); also elsewhere on the board
5V0_ISO_SW: C32.1, C33.1, C34.1, C35.1, C55.1, CN7.1, D14.1 (K), TP22.1 (1_1), U9.16 (VCC2), U12.3 (VCC1)
5V0_SW: C13.1, C22.2, C23.1, C24.1, C25.1, C26.1, C28.1, L1.2, R34.1, R37.1, TP15.1 (1_1), U6.3 (VIN), U8.9,10 (VIN), U10.1 (VBUS1); also elsewhere on the board
/CAN_RX: TP16.1 (1_1), U9.6 (OUTD); also elsewhere on the board
/CAN_SLEEP: TP19.1 (1_1), U9.3 (INA); also elsewhere on the board
/CAN_TX: TP17.1 (1_1), U9.5 (INC); also elsewhere on the board
/EN_ISO_PWR: R37.2, U7.6 (DIM), U7.7 (~EN), U8.8 (EN); also elsewhere on the board
/ISOLATED_COMMS/USB_ISO_N: CN8.A7 (D-), CN8.B7 (D-), U10.11 (DD-)
/ISOLATED_COMMS/USB_ISO_P: CN8.A6 (D+), CN8.B6 (D+), U10.10 (DD+)
/USB_D+: U10.7 (UD+); also elsewhere on the board
/USB_D-: U10.6 (UD-); also elsewhere on the board
/USB_nINT: R36.2, U11.4; also elsewhere on the board
GND: C13.2, C15.2, C18.2, C19.2, C20.2, C23.2, C24.2, C25.2, C26.2, C27.2, C28.2, C54.2, D13.2, R35.2, R39.2, U6.1 (GND), U7.8 (GND), U7.9 (GND), U8.1 (GND1), U8.11,12 (GND1), U9.2 (GND1), U9.8 (GND1), U10.2 (GND1), U10.8 (GND1), U11.3; also elsewhere on the board
GNDISO: C29.2, C30.2, C31.1, C32.2, C33.2, C34.2, C35.2, C55.2, CN7.4, CN7.MP (6), CN8.A12B1 (GND), CN8.B12A1 (GND), CN8.S1 (SHIELD), D15.3 (A), R40.2, R44.2, R45.1, R46.1, TP21.1 (1_1), U8.2 (GND2), U8.3,4 (GND2), U9.9 (GND2), U9.15 (GND2), U10.9 (GND2), U10.15 (GND2), U11.2, U12.2 (GND)
unnamed: CN8.A5 (CC1), R45.2
unnamed: CN8.B5 (CC2), R46.2
unnamed: C29.1, D14.2 (A), TP20.1 (1_1), U8.5,6 (VOUT)
unnamed: CN7.3, D15.2 (K), JP7.1 (A), U12.6 (CANL)
unnamed: JP7.2 (B), R47.2
unnamed: R41.1, U11.1
unnamed: C21.2, U7.4 (BST)
unnamed: C22.1, R34.2, R35.1, U7.1 (FB)
unnamed: C21.1, D13.1, L1.1, U7.5 (SW)
unnamed: R38.2, U10.4 (PDEN)
unnamed: R42.1, U10.12 (PIN)
unnamed: R40.1, U10.13 (SPD)
unnamed: R39.1, U10.5 (SPU)
unnamed: C30.1, R43.1, U10.16 (VBUS2)
unnamed: C27.1, R38.1, U10.3 (VDD1)
unnamed: C31.2, R42.2, U10.14 (VDD2)
unnamed: CN7.2, D15.1 (K), R47.1, U12.7 (CANH)
unnamed: U9.11 (IND), U12.4 (RXD)
unnamed: R44.1, U12.5 (SHDN)
unnamed: U9.14 (OUTA), U12.8 (STB)
unnamed: U9.12 (OUTC), U12.1 (TXD)
TOP_CELL: C18.1, C19.1, C20.1, U7.3 (VIN); also elsewhere on the board
VBUS_ISO: CN8.A9B4 (VBUS), CN8.B9A4 (VBUS), R41.2, R43.2

Notes on the sheet:
5V Isolated Switched for CAN
Isolated USB Interface
5V Switched
change sch symbool to CN?
Isolated CANbus 2.0B Interface
Chip Quiescent: 5uA OFF 250uaA ON
Higher current 5V DC-DC supply for comms interfaces
