ColtonTshudy/battery-node/bms-logic/battery-node.kicad_pcb

## KiCad design bms-logic/battery-node.kicad_pcb (continued)

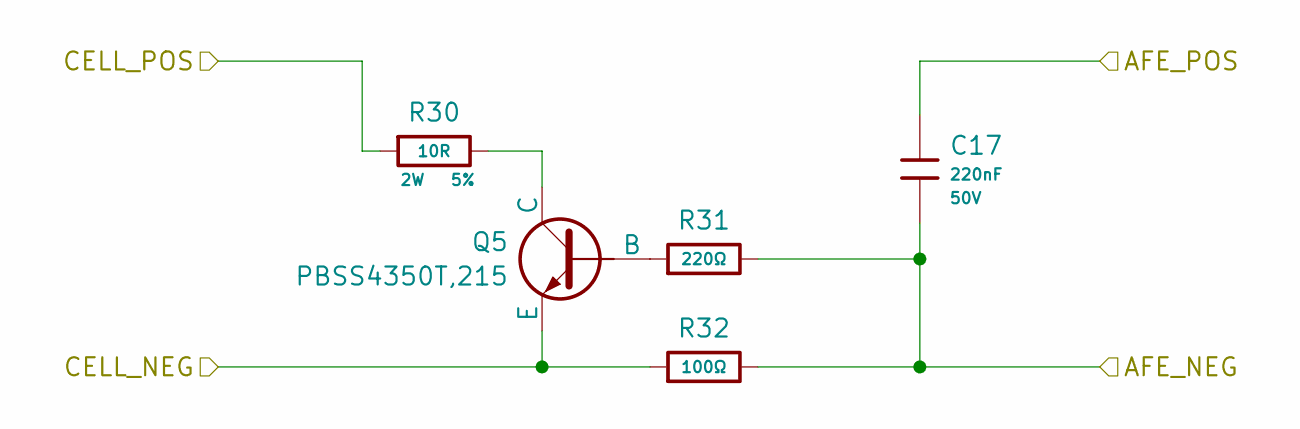
[picture p5: schematic balance.kicad_sch]

Parts:
C17: 220nF; C_0805; Voltage Rated 50V; Tolerance ±10%; Part CL21B224KBFNNNE; LCSC C5378
Q5: PBSS4350T,215; SOT-23; Part PBSS4350T,215
R30: 10R; R_2512_6332Metric; Tolerance 5%; Part FRP2512J100 TS
R31: 220Ω; R_0402; Tolerance ±1%; Overload Voltage (Max) 50V; Part 0402WGF2200TCE; LCSC C25091
R32: 100Ω; R_0402; Overload Voltage (Max) 50V; Tolerance ±1%; Part 0402WGF1000TCE; LCSC C25076

Connections:
/AFE/Cell1: Q5.2 (E), R32.1; also elsewhere on the board
/AFE/Cell2: R30.2; also elsewhere on the board
/AFE/VC1: C17.2, R31.2, R32.2; also elsewhere on the board
/AFE/VC2: C17.1; also elsewhere on the board
unnamed: Q5.1 (B), R31.1
unnamed: Q5.3 (C), R30.1

Parts of its further copies:
C36, C37, C38, C39, C40, C41, C42, C43, C44, C45, C46, C47, C48, C49: 220nF; C_0805; Voltage Rated 50V; Tolerance ±10%; Part CL21B224KBFNNNE; LCSC C5378
Q6, Q7, Q8, Q9, Q10, Q11, Q12, Q13, Q14, Q15, Q16, Q17, Q18, Q19: PBSS4350T,215; SOT-23; Part PBSS4350T,215
R48, R51, R54, R57, R60, R63, R66, R69, R72, R75, R78, R81, R84, R87: 10R; R_2512_6332Metric; Tolerance 5%; Part FRP2512J100 TS
R49, R52, R55, R58, R61, R64, R67, R70, R73, R76, R79, R82, R85, R88: 220Ω; R_0402; Tolerance ±1%; Overload Voltage (Max) 50V; Part 0402WGF2200TCE; LCSC C25091
R50, R53, R56, R59, R62, R65, R68, R71, R74, R77, R80, R83, R86, R89: 100Ω; R_0402; Overload Voltage (Max) 50V; Tolerance ±1%; Part 0402WGF1000TCE; LCSC C25076

Connections of its further copies:
/AFE/Cell2: Q6.2 (E), R50.1; also elsewhere on the board
/AFE/Cell3: Q7.2 (E), R48.2, R53.1; also elsewhere on the board
/AFE/Cell4: Q8.2 (E), R51.2, R56.1; also elsewhere on the board
/AFE/Cell5: Q9.2 (E), R54.2, R59.1; also elsewhere on the board
/AFE/Cell6: Q10.2 (E), R57.2, R62.1; also elsewhere on the board
/AFE/Cell7: Q11.2 (E), R60.2, R65.1; also elsewhere on the board
/AFE/Cell8: Q12.2 (E), R63.2, R68.1; also elsewhere on the board
/AFE/Cell9: Q13.2 (E), R66.2, R71.1; also elsewhere on the board
/AFE/Cell10: Q14.2 (E), R69.2, R74.1; also elsewhere on the board
/AFE/Cell11: Q15.2 (E), R72.2, R77.1; also elsewhere on the board
/AFE/Cell12: Q16.2 (E), R75.2, R80.1; also elsewhere on the board
/AFE/Cell13: Q17.2 (E), R78.2, R83.1; also elsewhere on the board
/AFE/Cell14: Q18.2 (E), R81.2, R86.1; also elsewhere on the board
/AFE/Cell15: Q19.2 (E), R84.2, R89.1; also elsewhere on the board
/AFE/Cell16: R87.2; also elsewhere on the board
/AFE/VC2: C36.2, R49.2, R50.2; also elsewhere on the board
/AFE/VC3: C36.1, C37.2, R52.2, R53.2; also elsewhere on the board
/AFE/VC4: C37.1, C38.2, R55.2, R56.2; also elsewhere on the board
/AFE/VC5: C38.1, C39.2, R58.2, R59.2; also elsewhere on the board
/AFE/VC6: C39.1, C40.2, R61.2, R62.2; also elsewhere on the board
/AFE/VC7: C40.1, C41.2, R64.2, R65.2; also elsewhere on the board
/AFE/VC8: C41.1, C42.2, R67.2, R68.2; also elsewhere on the board
/AFE/VC9: C42.1, C43.2, R70.2, R71.2; also elsewhere on the board
/AFE/VC10: C43.1, C44.2, R73.2, R74.2; also elsewhere on the board
/AFE/VC11: C44.1, C45.2, R76.2, R77.2; also elsewhere on the board
/AFE/VC12: C45.1, C46.2, R79.2, R80.2; also elsewhere on the board
/AFE/VC13: C46.1, C47.2, R82.2, R83.2; also elsewhere on the board
/AFE/VC14: C47.1, C48.2, R85.2, R86.2; also elsewhere on the board
/AFE/VC15: C48.1, C49.2, R88.2, R89.2; also elsewhere on the board
/AFE/VC16: C49.1; also elsewhere on the board
unnamed: Q6.1 (B), R49.1
unnamed: Q6.3 (C), R48.1
unnamed: Q7.1 (B), R52.1
unnamed: Q7.3 (C), R51.1
unnamed: Q8.1 (B), R55.1
unnamed: Q8.3 (C), R54.1
unnamed: Q9.1 (B), R58.1
unnamed: Q9.3 (C), R57.1
unnamed: Q10.1 (B), R61.1
unnamed: Q10.3 (C), R60.1
unnamed: Q11.1 (B), R64.1
unnamed: Q11.3 (C), R63.1
unnamed: Q12.1 (B), R67.1
unnamed: Q12.3 (C), R66.1
unnamed: Q13.1 (B), R70.1
unnamed: Q13.3 (C), R69.1
unnamed: Q14.1 (B), R73.1
unnamed: Q14.3 (C), R72.1
unnamed: Q15.1 (B), R76.1
unnamed: Q15.3 (C), R75.1
unnamed: Q16.1 (B), R79.1
unnamed: Q16.3 (C), R78.1
unnamed: Q17.1 (B), R82.1
unnamed: Q17.3 (C), R81.1
unnamed: Q18.1 (B), R85.1
unnamed: Q18.3 (C), R84.1
unnamed: Q19.1 (B), R88.1
unnamed: Q19.3 (C), R87.1

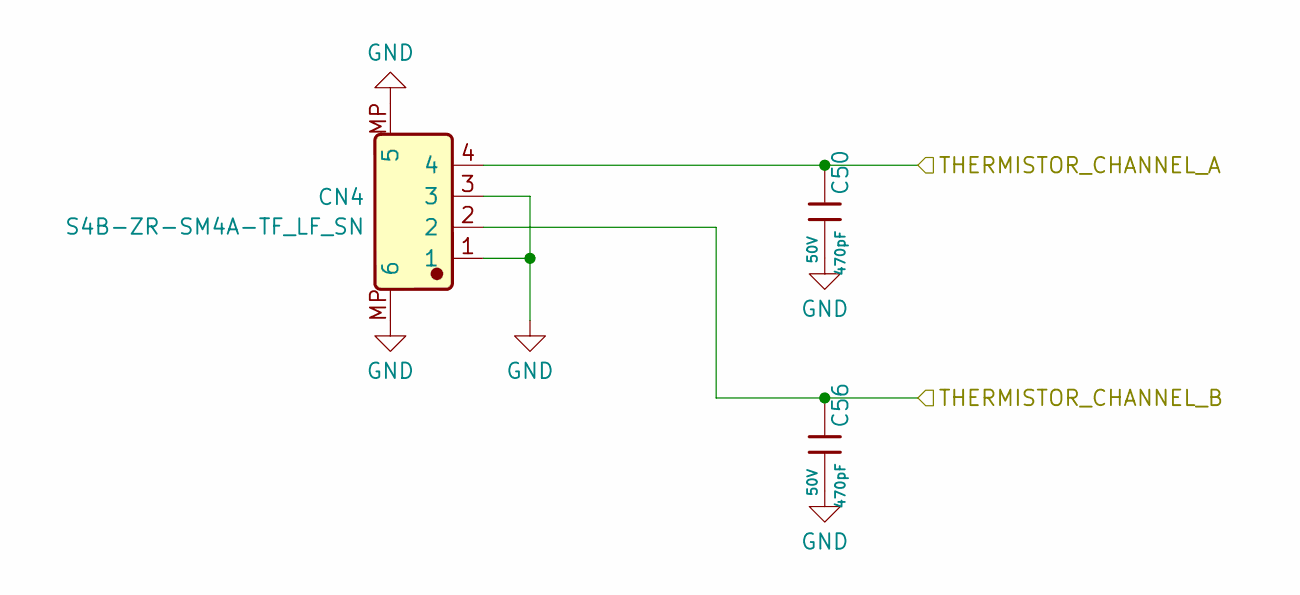
[picture p6: schematic thermistor.kicad_sch]

Parts:
C50, C56: 470pF; C_0402; Voltage Rated 50V; Tolerance ±10%; Part 0402B471K500NT; LCSC C1537
CN4: S4B-ZR-SM4A-TF_LF_SN; JST_ZH_S4B-ZR-SM4A-TF_1x04-1MP_P1.50mm_Horizontal; Manufacturer Part S4B-ZR-SM4A-TF(LF)(SN); LCSC C485354

Connections:
/AFE/TEMP_CELLS_1: C50.1, CN4.4; also elsewhere on the board
/AFE/TEMP_CELLS_2: C56.1, CN4.2; also elsewhere on the board
GND: C50.2, C56.2, CN4.1, CN4.3, CN4.MP (6); also elsewhere on the board

Parts of its further copies:
C51, C57: 470pF; C_0402; Voltage Rated 50V; Tolerance ±10%; Part 0402B471K500NT; LCSC C1537
CN3: S4B-ZR-SM4A-TF_LF_SN; JST_ZH_S4B-ZR-SM4A-TF_1x04-1MP_P1.50mm_Horizontal; Manufacturer Part S4B-ZR-SM4A-TF(LF)(SN); LCSC C485354

Connections of its further copies:
/AFE/TEMP_CELLS_3: C51.1, CN3.4; also elsewhere on the board
/AFE/TEMP_CELLS_4: C57.1, CN3.2; also elsewhere on the board
GND: C51.2, C57.2, CN3.1, CN3.3, CN3.MP (6); also elsewhere on the board

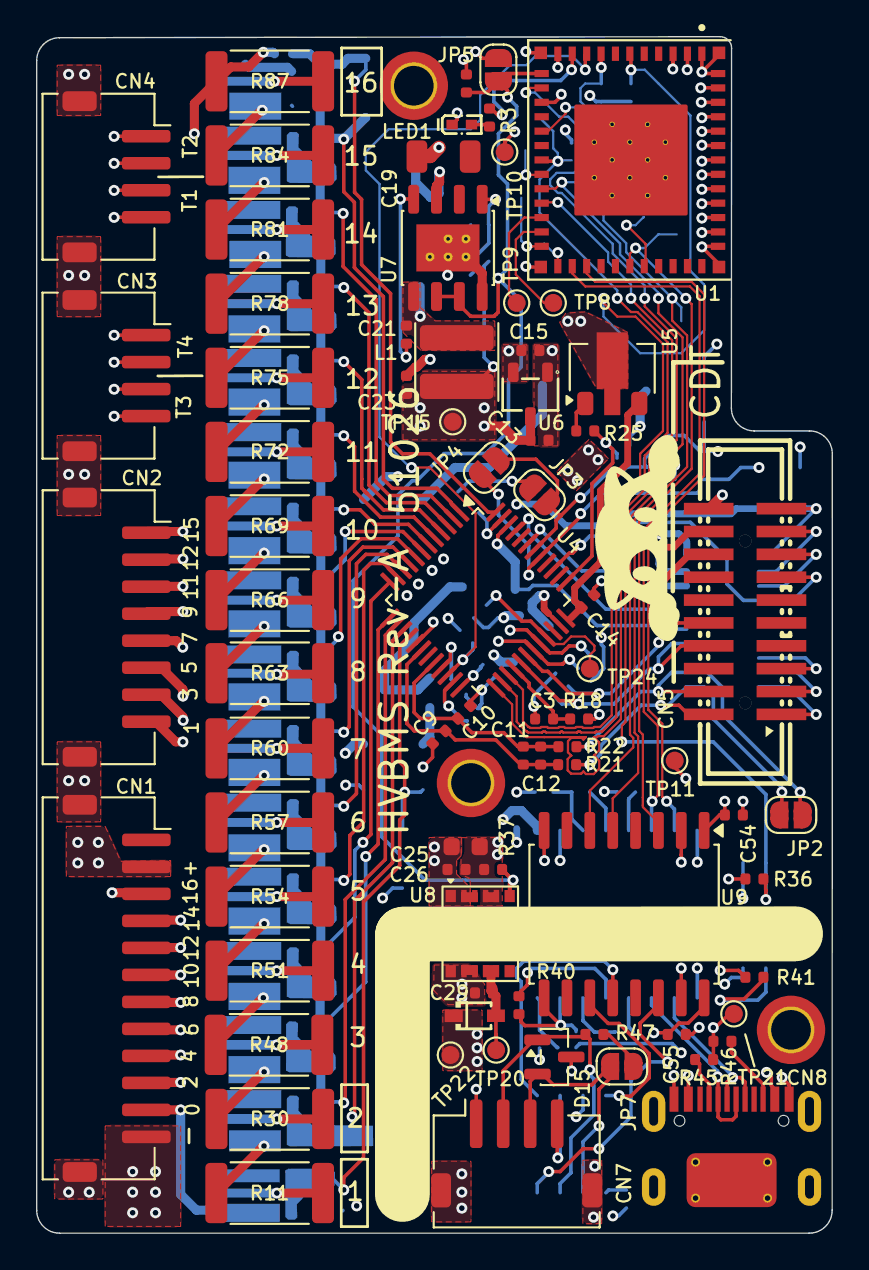
[picture p7: board battery-node.kicad_pcb from above]

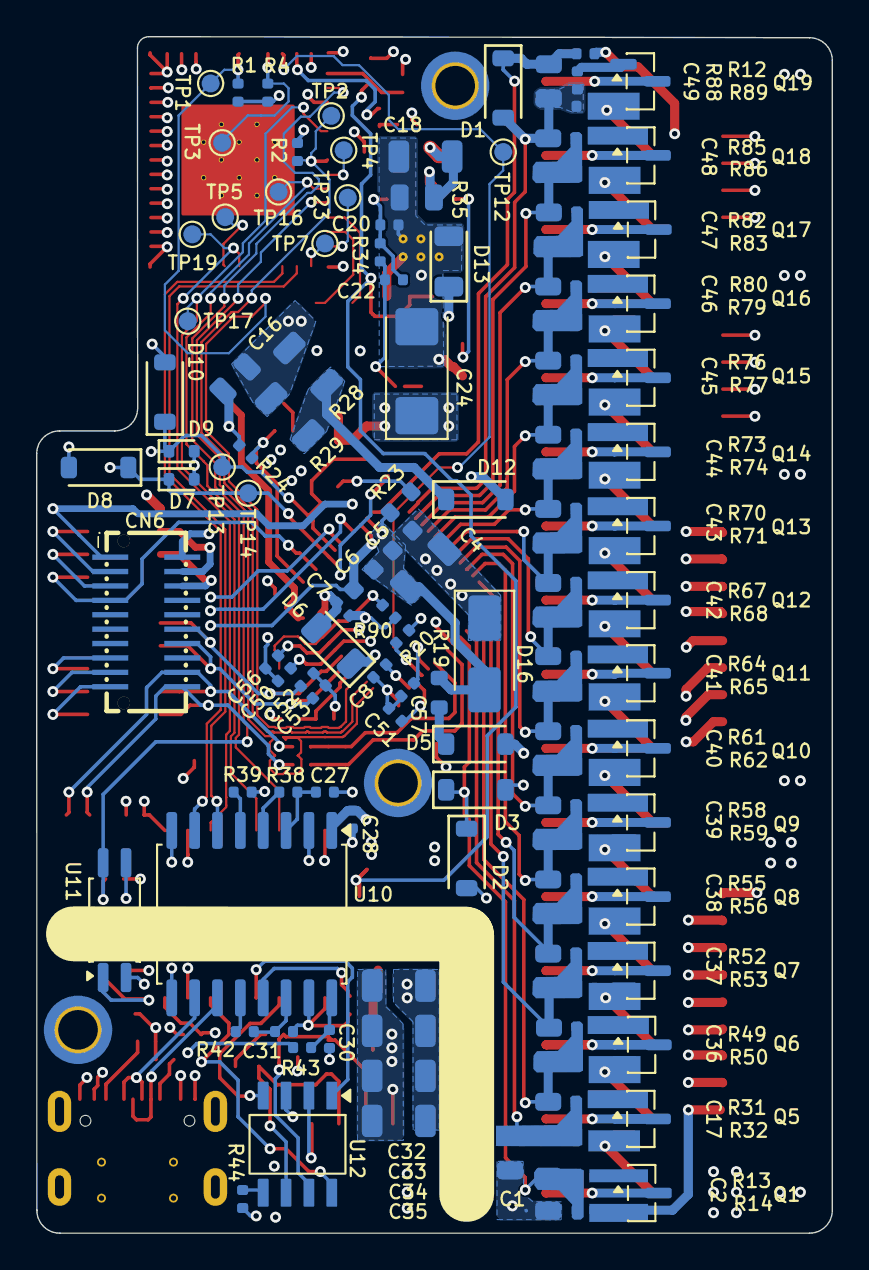
[picture p8: board battery-node.kicad_pcb from below]

Board: 4 copper layers, 44.2 x 66.5 mm, 216 parts (136 on the bottom side), 144 nets.
