ColtonTshudy/battery-node/(commit log)

2025-12-06 began project
    [battery-node.kicad_pcb, battery-node.kicad_sch]
2026-01-13 Start of project
    [battery-node.kicad_sch]
2026-01-24 Continued work on adding subcircuits for L99BM114
    [battery-node.kicad_sch, cell_sense.kicad_sch, untitled.kicad_sch]
2026-01-25 gave untitled file a name
    [battery-node.kicad_sch, bms.kicad_sch, cell_sense.kicad_sch]
2026-01-25 updated to use generics for passives
    [bms.kicad_sch, cell_sense.kicad_sch]
2026-03-29 added BQ chip
    [battery-node.kicad_sch, bms.kicad_sch, cell_sense.kicad_sch]
2026-04-08 removed regulator circuit, more mosfet testing with ltspice
    [battery-node.kicad_pcb, bms.kicad_sch]
2026-04-09 Added new cell balancing circuit to handle 0.4 A at 4V per cell
    [bms.kicad_sch]
2026-04-23 Updated simulations to fix turn-off issues at negative voltages. Added power stage to BMS based on sim 5
    [CD_Control.kicad_sch, battery-node.kicad_sch, bms.kicad_sch, cell_balancer.kicad_sch]
2026-04-27 More sims, more buildout
    [CD_Control.kicad_sch, battery-node.kicad_sch, bms.kicad_sch]
2026-05-02 isolated comms
    [CAN.kicad_sch, CD_Control.kicad_sch, battery-node.kicad_sch, bms.kicad_sch, untitled.kicad_sch]
2026-05-03 comms updates
    [CAN.kicad_sch, battery-node.kicad_sch, bms.kicad_sch]
2026-05-03 adding diode or
    [CAN.kicad_sch, battery-node.kicad_sch, bms.kicad_sch, cell_balancer.kicad_sch, cell_sense.kicad_sch, untitled.kicad_sch]
2026-05-04 added precharge circuit, filled in placeholder parts
    [CAN.kicad_sch, CD_Control.kicad_sch, battery-node.kicad_pcb, battery-node.kicad_sch, bms.kicad_sch]
2026-05-04 prepping for split into 2 boards
    [CD_Control.kicad_sch, battery-node.kicad_sch, bms.kicad_sch]
2026-05-05 started layout
    [CAN.kicad_sch, CD_Control.kicad_sch, battery-node.kicad_pcb, battery-node.kicad_sch, bms.kicad_sch]
2026-05-05 added subdirectories
    [CAN.kicad_sch, CD_Control.kicad_sch, balance.kicad_sch, battery-node.kicad_pcb, battery-node.kicad_sch, bms-power.kicad_pcb, bms-power.kicad_sch, bms.kicad_sch]
2026-05-06 started afe layout
    [CAN.kicad_sch, balance.kicad_sch, battery-node.kicad_pcb, battery-node.kicad_sch, bms.kicad_sch, thermistor.kicad_sch]
2026-05-07 power supply layout
    [CAN.kicad_sch, battery-node.kicad_pcb, battery-node.kicad_sch]
2026-05-08 trying to flip resistor directions (fail)
    [battery-node.kicad_pcb]
2026-05-09 old resistor array direction
    [battery-node - old.kicad_pcb]
2026-05-09 kicad 10.0.1 before update to .2
    [CAN.kicad_sch, battery-node.kicad_pcb, battery-node.kicad_sch, bms.kicad_sch, thermistor.kicad_sch]
2026-05-10 more layout, removed some unnecessary features
    [CAN.kicad_sch, battery-node.kicad_pcb, battery-node.kicad_sch, bms.kicad_sch]
2026-05-10 done with layout, need to address some DRC
    [CAN.kicad_sch, battery-node.kicad_pcb, battery-node.kicad_sch, bms.kicad_sch, thermistor.kicad_sch]
